alan-bov/frisbee_tracker/reference material/IO Chart for Programming Reference.pptx

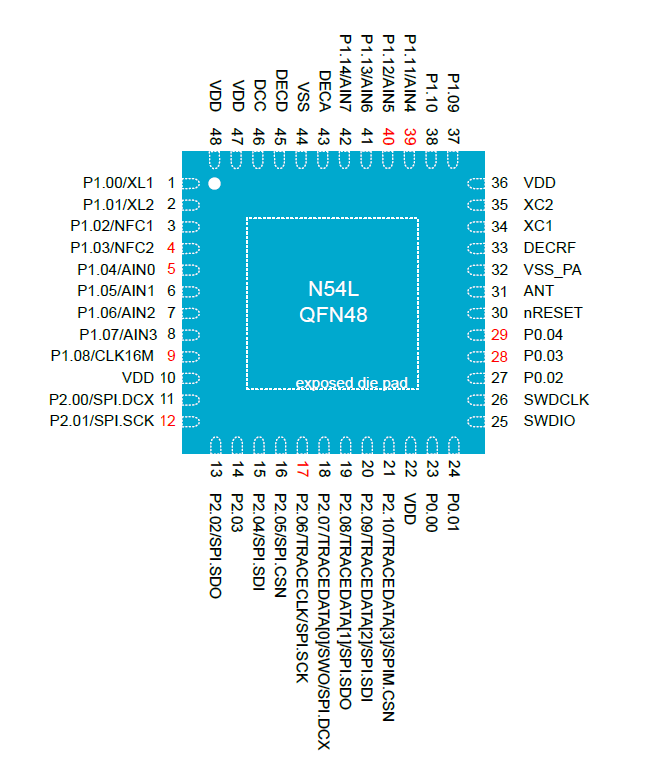
[picture p1: figure]

Analog reading of
voltage across battery

From BMI323
I2C communication lines

V_bat Input

SDA Line

SCL Line

INT2

From BMI323
INT1 and INT2 configurable

INT1

Charging LED indicators
D1 on top, D4 on bottom

D1 Toggle

D2 Toggle

D3 Toggle

D4 Toggle

Note: Default I2C address of BMI 323 is 0x68

PGOOD

CHG

From BQ24072RGTT
PGOOD on when charging complete
CHG on during charging
