alan-bov/frisbee_tracker/reference material/board outline dxf.DXF

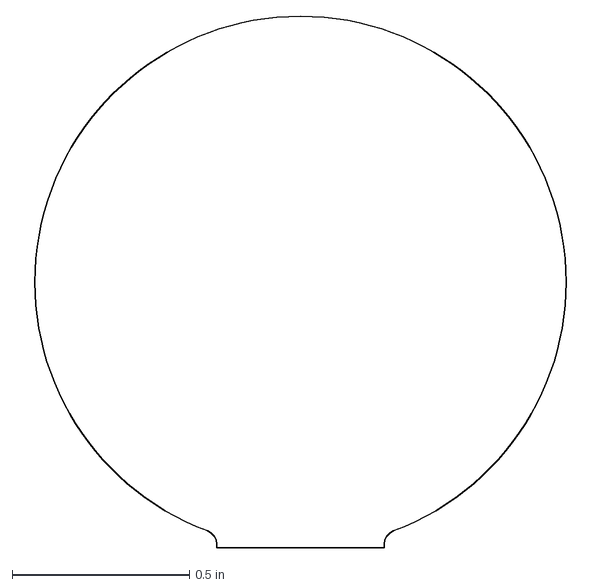
[picture p2: CAD file, 2025-10-27]
reference material/board outline dxf.DXF
1.60 x 1.50 in
