alan-bov/frisbee_tracker/step/SS14.STEP

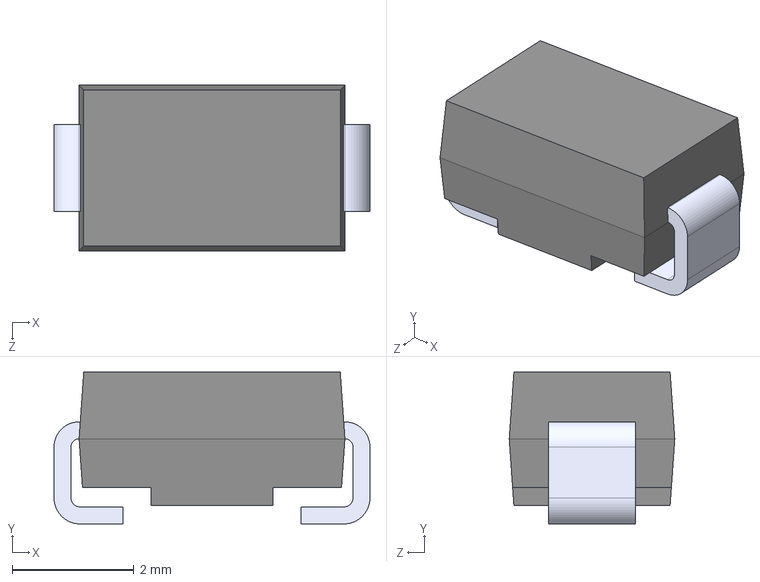
[picture p3: CAD file, 2025-11-05]
step/SS14.STEP
5.20 x 2.50 x 2.72 mm
