alan-bov/frisbee_tracker/step/SMD26PL-TP.stp

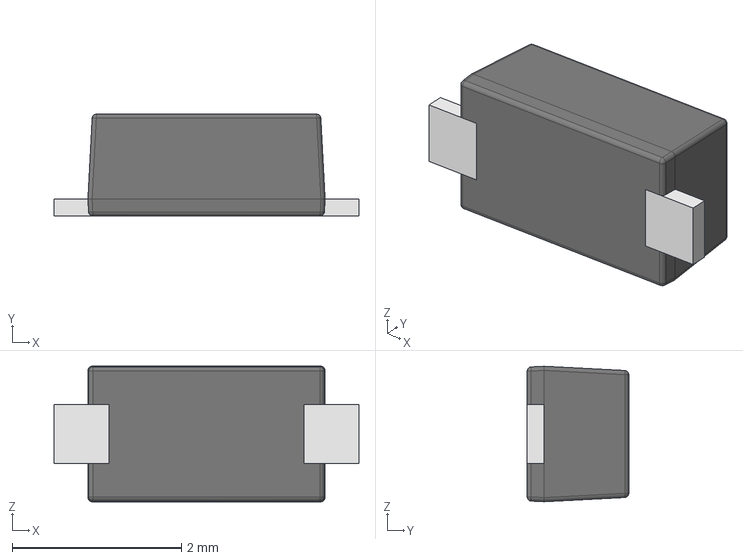
[picture p4: CAD file, 2025-11-05]
step/SMD26PL-TP.stp
3.60 x 1.20 x 1.60 mm
��2
��1
