alan-bov/frisbee_tracker/step/FTSH-103-01-L-D.step

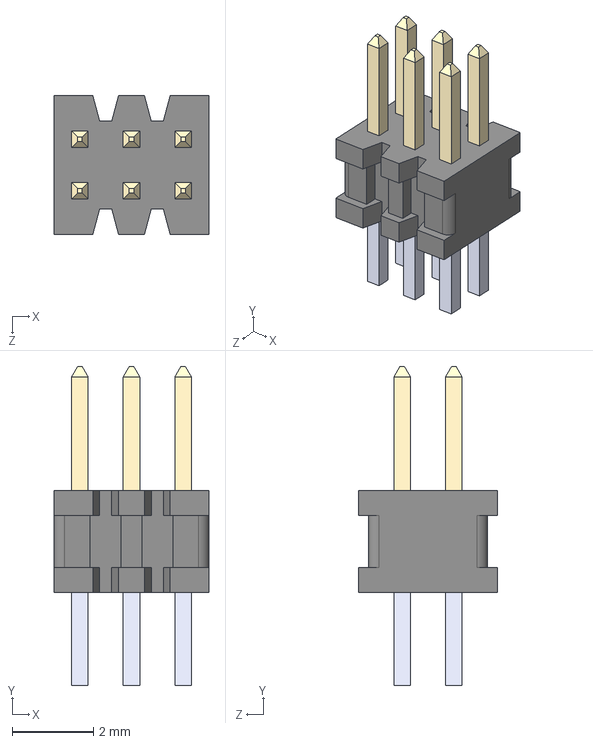
[picture p5: CAD file, 2025-10-31]
step/FTSH-103-01-L-D.step
3.81 x 7.85 x 3.43 mm
