alan-bov/frisbee_tracker/step/BLM18KG121TN1D.step

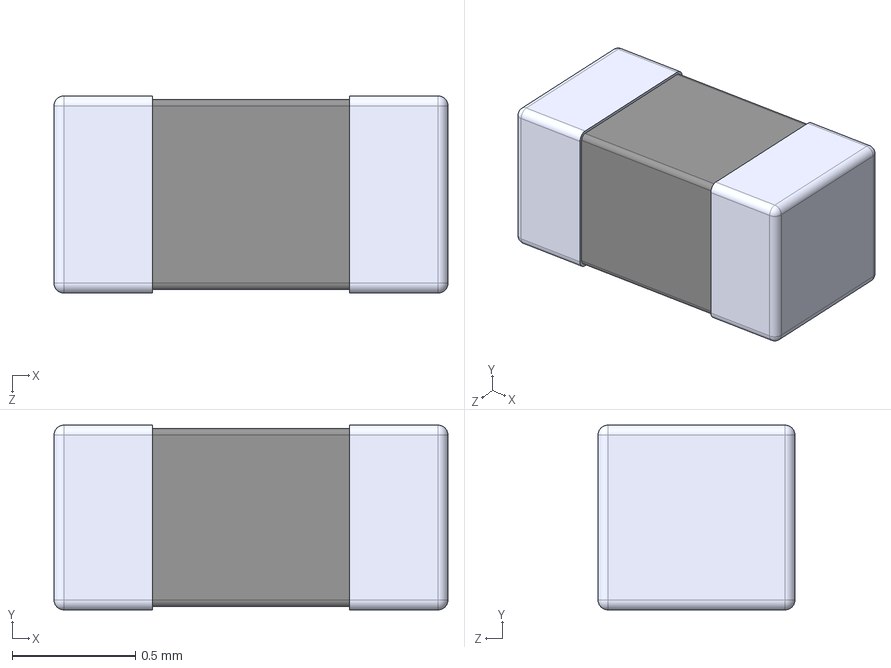
[picture p6: CAD file, 2025-10-27]
step/BLM18KG121TN1D.step
1.60 x 0.75 x 0.8 mm
