alan-bov/frisbee_tracker/step/LQP03HQ3N5B02D.step

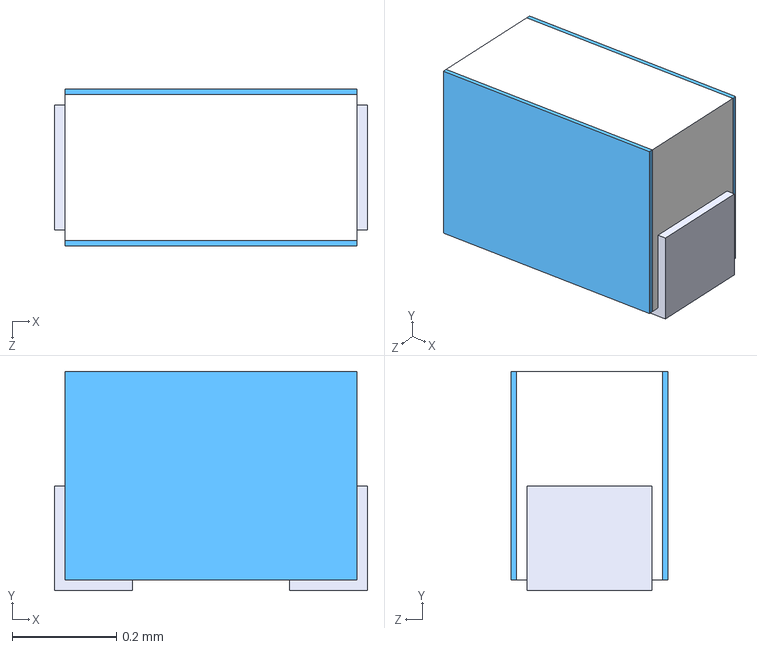
[picture p7: CAD file, 2025-10-27]
step/LQP03HQ3N5B02D.step
0.6 x 0.42 x 0.3 mm
