alan-bov/frisbee_tracker/step/ECS-320-8-37B2-JTY-TR.stp

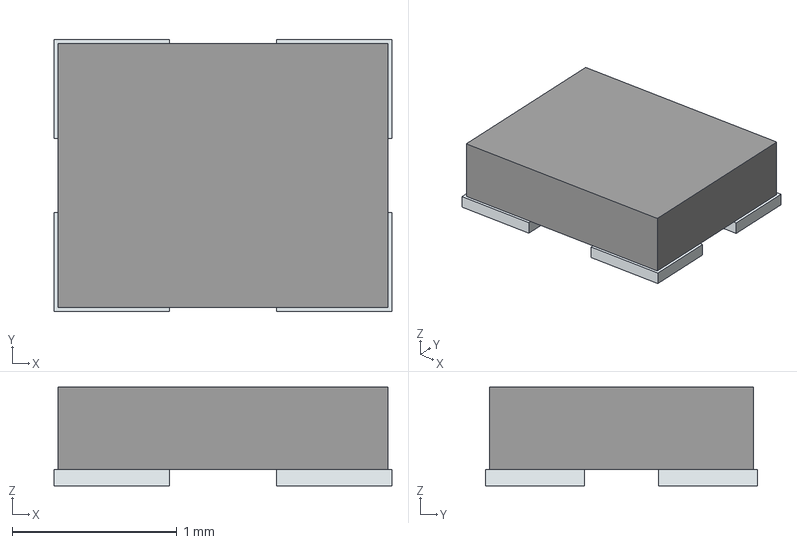
[picture p8: CAD file, 2025-10-27]
step/ECS-320-8-37B2-JTY-TR.stp
2.05 x 1.65 x 0.6 mm
Pins
