alan-bov/frisbee_tracker/step/RFANT3216120A5T.step

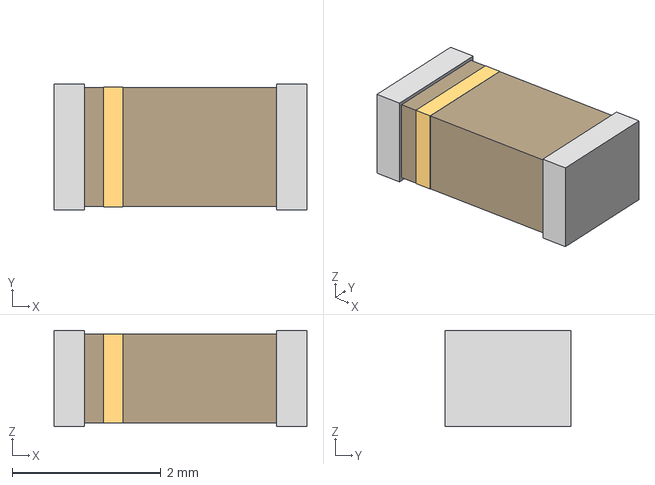
[picture p9: CAD file, 2025-10-24]
step/RFANT3216120A5T.step
3.40 x 1.70 x 1.29 mm
