alan-bov/frisbee_tracker/step/FTSH-105-01-L-DV-K.stp

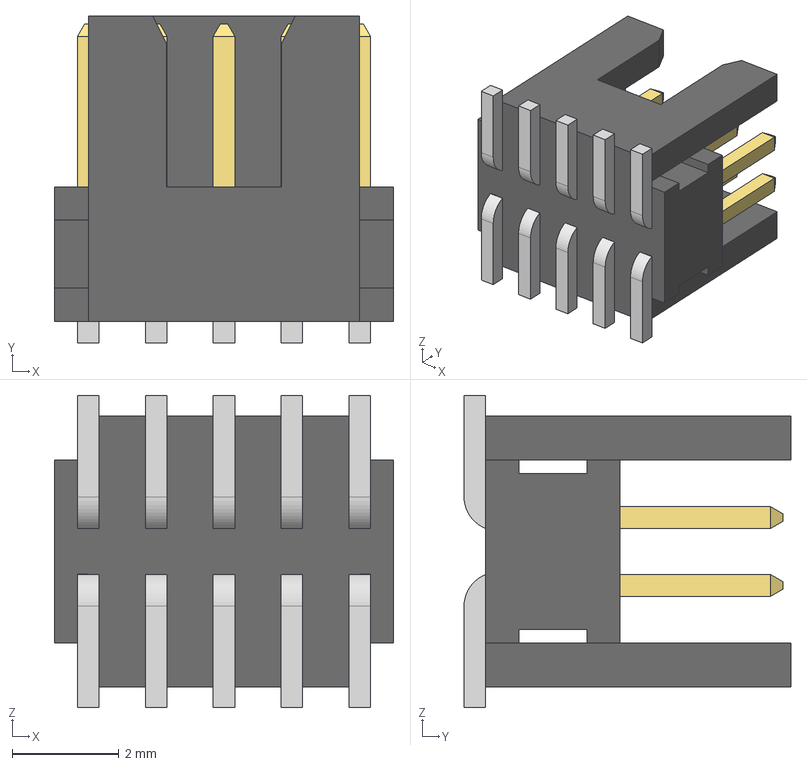
[picture p10: CAD file, 2025-10-24]
step/FTSH-105-01-L-DV-K.stp
6.35 x 6.12 x 5.84 mm
FTSH-105-01-L-DV-K_body
FTSH-105-01-L-DV-K_pins1
FTSH-105-01-L-DV-K_pins2
