alan-bov/frisbee_tracker/step/BSS138.step

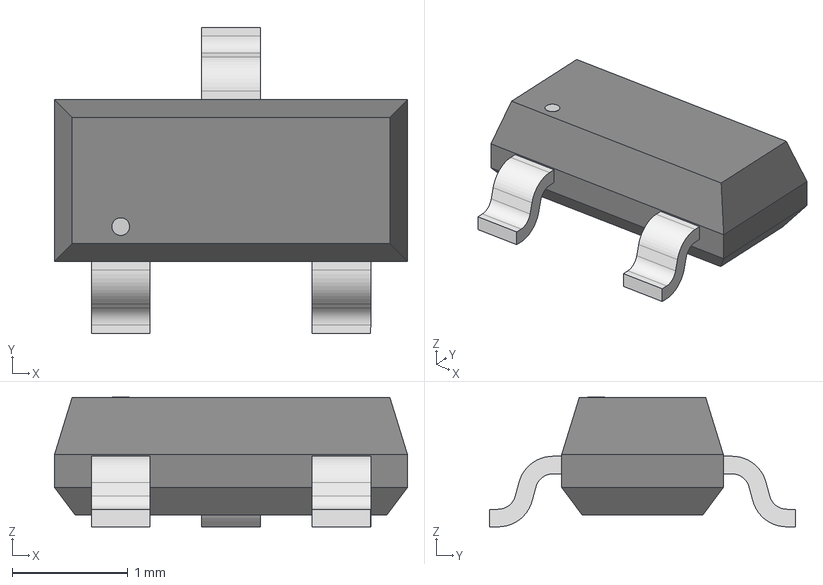
[picture p11: CAD file, 2025-10-24]
step/BSS138.step
3.05 x 2.64 x 1.12 mm
