alan-bov/frisbee_tracker/step/AP2210N-3.3TRG1.step

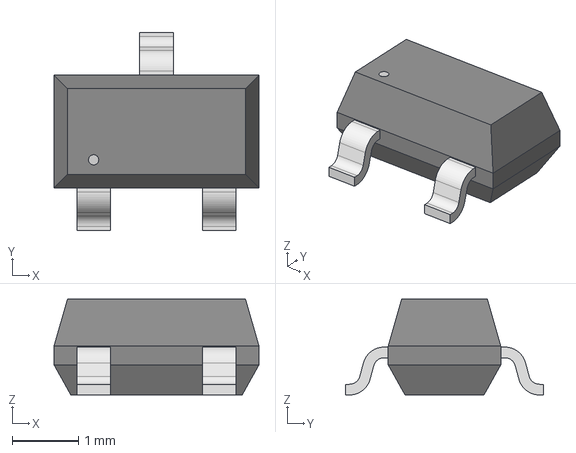
[picture p12: CAD file, 2025-10-23]
step/AP2210N-3.3TRG1.step
3.10 x 3.00 x 1.45 mm
