alan-bov/frisbee_tracker/step/NRF54L05-QFAA-R7.stp

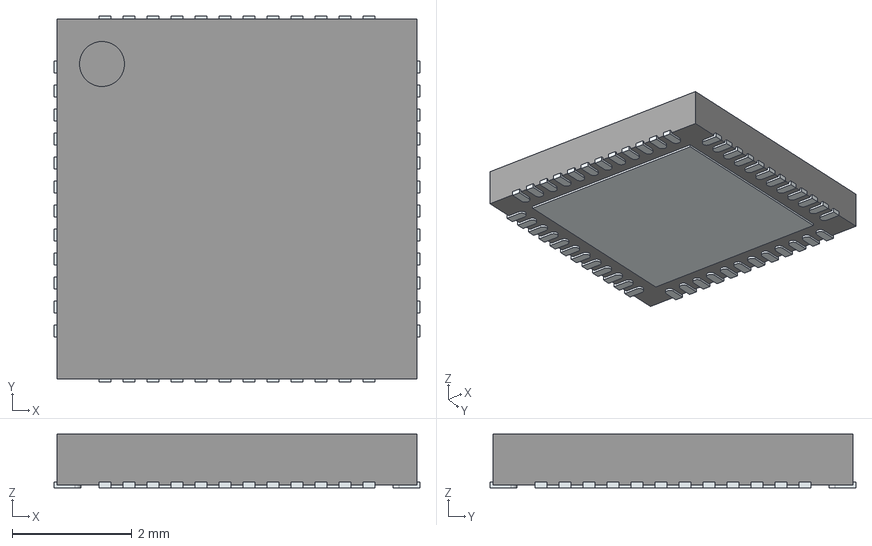
[picture p13: CAD file, 2025-10-23]
step/NRF54L05-QFAA-R7.stp
6.10 x 6.10 x 0.9 mm
ThermalPin
PinsArrayLR
PinsArrayTB
