alan-bov/frisbee_tracker/step/BMI323.step

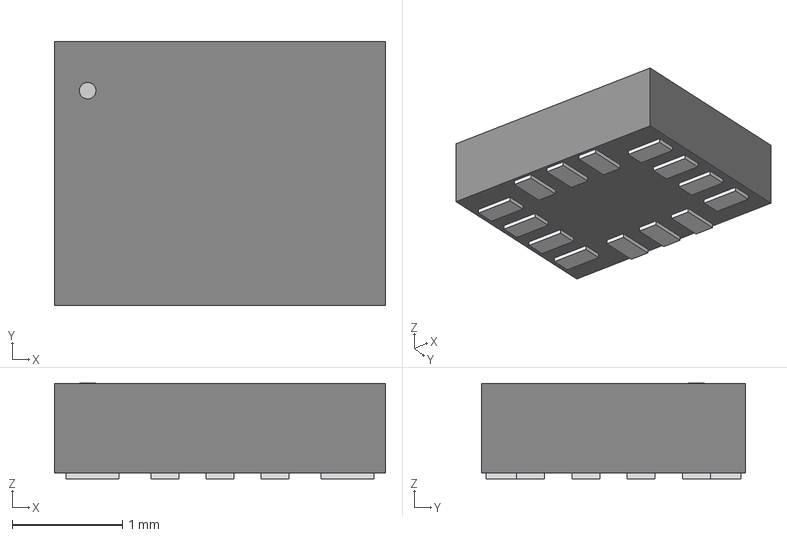
[picture p14: CAD file, 2025-10-23]
step/BMI323.step
3.00 x 2.39 x 0.866 mm
