alan-bov/frisbee_tracker/step/UJC-H-G-SMT-2-P6-TR.step

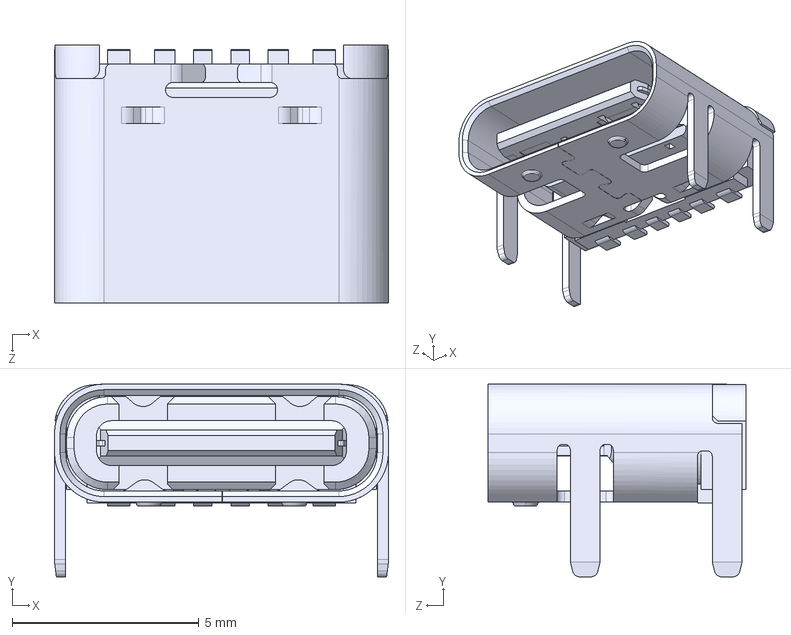
[picture p15: CAD file, 2025-10-23]
step/UJC-H-G-SMT-2-P6-TR.step
8.94 x 5.16 x 6.90 mm
