alan-bov/frisbee_tracker/step/BQ24072RGTT.step

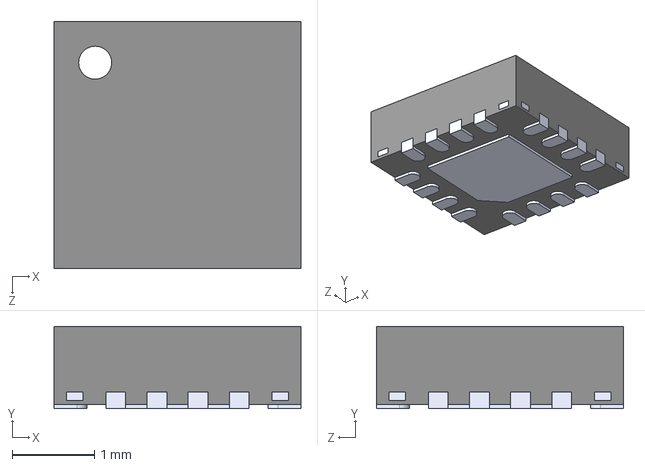
[picture p16: CAD file, 2025-10-23]
step/BQ24072RGTT.step
3.00 x 1.00 x 3.00 mm
