alan-bov/frisbee_tracker/(list of files, drawings)

Other design files:
reference material/nRF54L15-QFAA Reference Layout 0_8/Altium Designer files/nRF54L15_qfaa_4L_config1.PcbDoc
reference material/nRF54L15-QFAA Reference Layout 0_8/Altium Designer files/nRF54L15_qfaa_4L_config1.PrjPCB
reference material/nRF54L15-QFAA Reference Layout 0_8/Altium Designer files/nRF54L15_qfaa_4L_config1.SchDoc
