alan-bov/frisbee_tracker/frisbee_tracker/frisbee_tracker.kicad_pcb

## KiCad design frisbee_tracker/frisbee_tracker.kicad_pcb (2025-11-05)

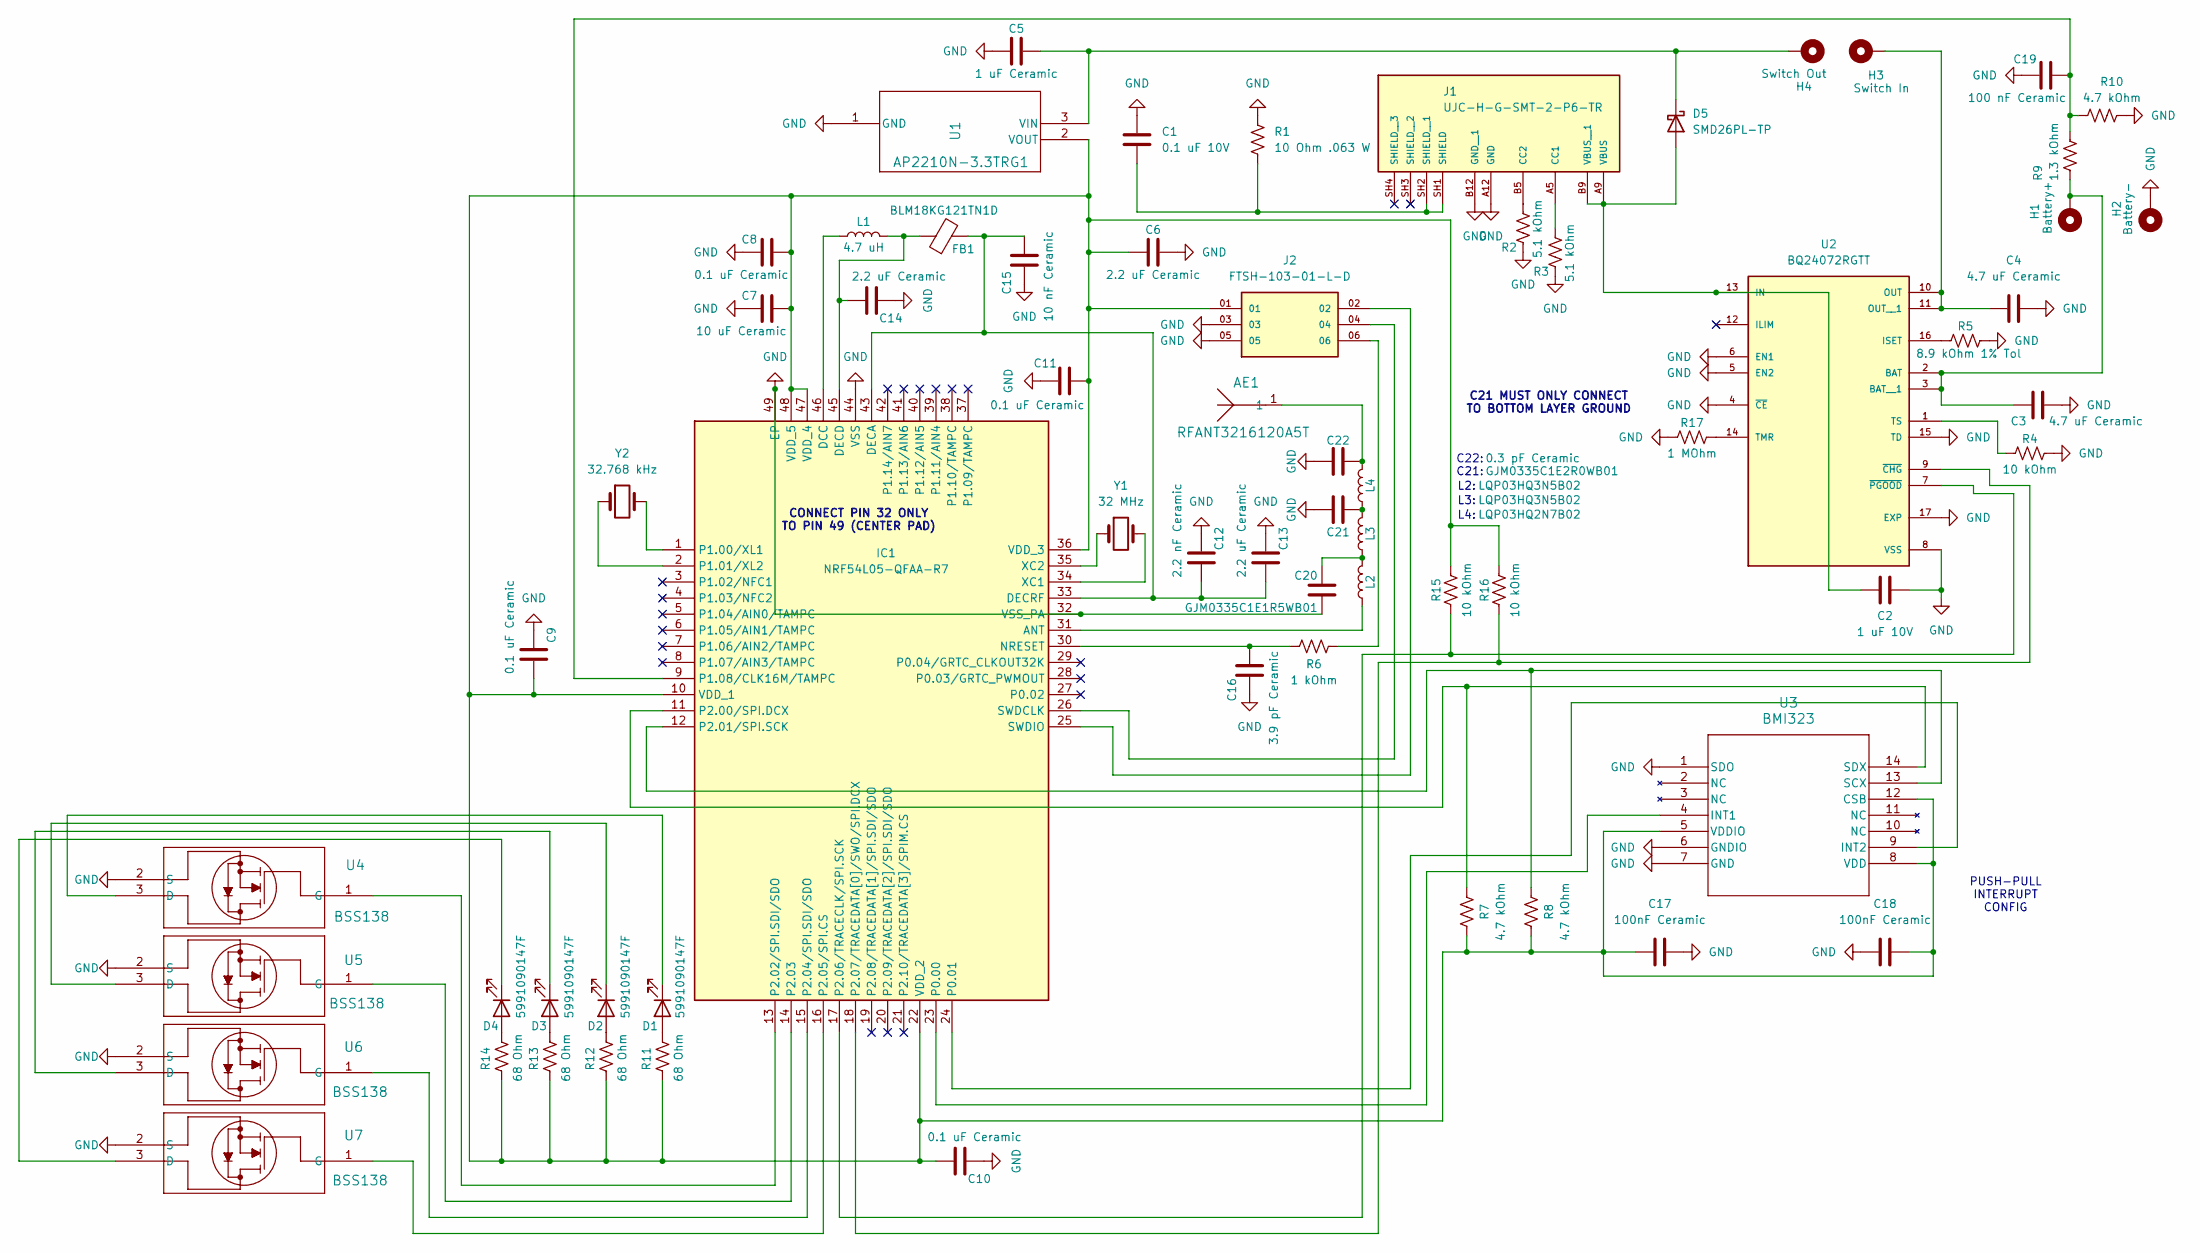
[picture p17: schematic frisbee_tracker.kicad_sch]

Parts:
AE1: RFANT3216120A5T
C1: 0.1 uF 10V; C_0603_1608Metric
C2: 1 uF 10V; C_0603_1608Metric
C3, C4: 4.7 uF Ceramic; C_0603_1608Metric
C5: 1 uF Ceramic; C_0603_1608Metric
C6, C13, C14: 2.2 uF Ceramic; C_0603_1608Metric
C7: 10 uF Ceramic; C_0603_1608Metric
C8, C9, C10, C11: 0.1 uF Ceramic; C_0603_1608Metric
C12: 2.2 nF Ceramic; C_0603_1608Metric
C15: 10 nF Ceramic; C_0603_1608Metric
C16: 3.9 pF Ceramic; C_0603_1608Metric
C17, C18: 100nF Ceramic; C_0603_1608Metric
C19: 100 nF Ceramic; C_0603_1608Metric
C20: GJM0335C1E1R5WB01; C_0201_0603Metric
C21: GJM0335C1E2R0WB01; C_0201_0603Metric
C22: 0.3 pF Ceramic; C_0603_1608Metric
D1, D2, D3, D4: 5991090147F; LED_0603_1608Metric
D5: SMD26PL-TP
FB1: BLM18KG121TN1D
H1: Battery+; PinHeader_1x01_P1.27mm_Vertical
H2: Battery-; PinHeader_1x01_P1.27mm_Vertical
H3: Switch In; PinHeader_1x01_P1.27mm_Vertical
H4: Switch Out; PinHeader_1x01_P1.27mm_Vertical
IC1: NRF54L05-QFAA-R7; Mouser Part Number 949-NRF54L05-QFAA-R7
J1: UJC-H-G-SMT-2-P6-TR; PARTREV 1.0
J2: FTSH-103-01-L-D; PARTREV B
L1: 4.7 uH; L_0603_1608Metric
L2: LQP03HQ2N7B02; LQP03HQ2N7B02D
L3, L4: LQP03HQ3N5B02; LQP03HQ3N5B02D
R1: 10 Ohm .063 W; R_0603_1608Metric
R2, R3: 5.1 kOhm; R_0603_1608Metric
R4, R15, R16: 10 kOhm; R_0603_1608Metric
R5: 8.9 kOhm 1% Tol; R_0603_1608Metric
R6: 1 kOhm; R_0603_1608Metric
R7, R8, R10: 4.7 kOhm; R_0603_1608Metric
R9: 1.3 kOhm; R_0603_1608Metric
R11, R12, R13, R14: 68 Ohm; R_0603_1608Metric
R17: 1 MOhm; R_0603_1608Metric
U1: AP2210N-3.3TRG1
U2: BQ24072RGTT; PARTREV N
U3: BMI323
U4, U5, U6, U7: BSS138
Y1: 32 MHz; ECS-320-8-37B2-JTY-TR
Y2: 32.768 kHz; Q 0,032768-JTX210-7-20-T1-HMR-70K-LF

Connections:
unnamed: AE1.1, C22.2, L4.2
unnamed: C20.2, L2.2, L3.1
unnamed: C21.1, L3.2, L4.1
unnamed: D1.2 (A), R11.1
unnamed: D1.1 (K), U4.3 (D)
unnamed: D2.2 (A), R12.1
unnamed: D2.1 (K), U5.3 (D)
unnamed: D3.2 (A), R13.1
unnamed: D3.1 (K), U6.3 (D)
unnamed: D4.2 (A), R14.1
unnamed: D4.1 (K), U7.3 (D)
unnamed: C2.1, D5.2 (A), J1.A9 (VBUS), J1.B9 (VBUS__1), U2.13 (IN)
unnamed 12: C5.2, D5.1 (K), H4.1, U1.3 (VIN); also elsewhere on the board
unnamed: IC1.31 (ANT), L2.1
unnamed: IC1.46 (DCC), L1.1
unnamed: C12.2, C13.2, C15.2, FB1.2, IC1.33 (DECRF), IC1.43 (DECA)
unnamed: C14.2, FB1.1, IC1.45 (DECD), L1.2
unnamed: C16.2, IC1.30 (NRESET), R6.1
unnamed: IC1.23 (P0.00), U3.4 (INT1)
unnamed: IC1.24 (P0.01), U3.9 (INT2)
unnamed: IC1.1 (P1.00/XL1), Y2.2
unnamed: IC1.2 (P1.01/XL2), Y2.1
unnamed: C19.2, IC1.9 (P1.08/CLK16M/TAMPC), R9.1, R10.1
unnamed: IC1.11 (P2.00/SPI.DCX), R7.2, U3.14 (SDX)
unnamed: IC1.12 (P2.01/SPI.SCK), R8.2, U3.13 (SCX)
unnamed: IC1.13 (P2.02/SPI.SDI/SDO), U4.1 (G)
unnamed: IC1.14 (P2.03), U5.1 (G)
unnamed: IC1.15 (P2.04/SPI.SDI/SDO), U6.1 (G)
unnamed: IC1.16 (P2.05/SPI.CS), U7.1 (G)
unnamed: IC1.17 (P2.06/TRACECLK/SPI.SCK), R15.1, U2.7 (~PGOOD)
unnamed: IC1.18 (P2.07/TRACEDATA[0]/SWO/SPI.DCX), R16.1, U2.9 (~CHG)
unnamed: IC1.26 (SWDCLK), J2.04
unnamed: IC1.25 (SWDIO), J2.02
unnamed: C6.1, C7.2, C8.2, C9.2, C10.2, C11.2, C17.1, C18.2, IC1.10 (VDD_1), IC1.22 (VDD_2), IC1.36 (VDD_3), IC1.47 (VDD_4), IC1.48 (VDD_5), J2.01, R7.1, R8.1, R11.2, R12.2, R13.2, R14.2, R15.2, R16.2, U1.2 (VOUT), U3.5 (VDDIO), U3.8 (VDD), U3.12 (CSB)
unnamed: IC1.35 (XC2), Y1.1
unnamed: J1.A5 (CC1), R3.1
unnamed: J1.B5 (CC2), R2.1
unnamed: C1.2, J1.SH1 (SHIELD), J1.SH2 (SHIELD__1), R1.2
unnamed: J2.06, R6.2
unnamed 39: C3.1, H1.1, R9.2, U2.2 (BAT), U2.3 (BAT__1); also elsewhere on the board
unnamed: R5.1, U2.16 (ISET)
unnamed 41: C4.1, H3.1, U2.10 (OUT), U2.11 (OUT__1); also elsewhere on the board
unnamed: R17.2, U2.14 (TMR)
unnamed: R4.1, U2.1 (TS)

Notes on the sheet:
C21:
CONNECT PIN 32 ONLY TO PIN 49 (CENTER PAD)
L3:
C21 MUST ONLY CONNECT TO BOTTOM LAYER GROUND
L4:
C22:
L2:
PUSH-PULL INTERRUPT CONFIG

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
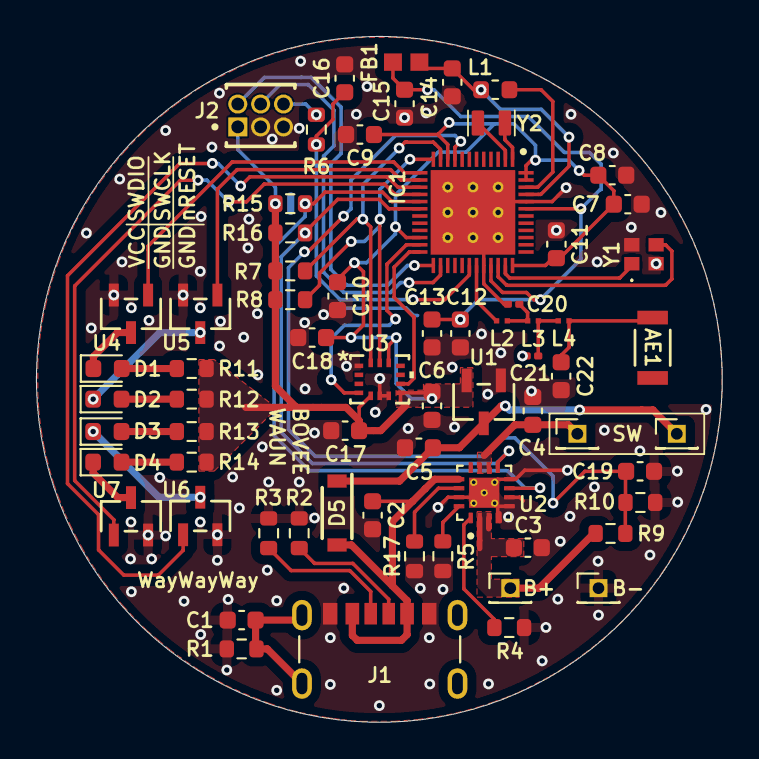
[picture p18: board frisbee_tracker.kicad_pcb from above]

Board: 2 copper layers, 38.1 x 38.1 mm, 66 parts (0 on the bottom side), 46 nets.

Other parts of the board:
B+: Battery+; PinHeader_1x01_P1.27mm_Vertical
B-: Battery-; PinHeader_1x01_P1.27mm_Vertical
SW: Switch Out; PinHeader_1x01_P1.27mm_Vertical
SW#2: Switch In; PinHeader_1x01_P1.27mm_Vertical

Their connections:
unnamed 12: SW.1; also elsewhere on the board
unnamed 39: B+.1; also elsewhere on the board
unnamed 41: SW#2.1; also elsewhere on the board
