alan-bov/frisbee_tracker/(commit log)

2025-10-23 started schematic design
    [frisbee_tracker.kicad_pcb, frisbee_tracker.kicad_sch]
2025-10-24 Rough draft of schematic complete
    [BSS138.step, FTSH-105-01-L-DV-K.stp, RFANT3216120A5T.step, frisbee_tracker.kicad_sch]
2025-10-27 start of PCB design
    [BLM18KG121TN1D.step, ECS-320-8-37B2-JTY-TR.stp, LQP03HQ2N7B02D.step, LQP03HQ3N5B02D.step, board outline dxf.DXF, frisbee_tracker.kicad_pcb, frisbee_tracker.kicad_sch]
2025-10-28 PCB design 75 percent complete
    [frisbee_tracker.kicad_pcb]
2025-10-29 rework on controller PCB wiring started
    [frisbee_tracker.kicad_pcb]
2025-10-30 PCB rework of MCU
    [frisbee_tracker.kicad_pcb]
2025-10-31 PCB design 90% complete
    [FTSH-103-01-L-D.step, frisbee_tracker.kicad_pcb, frisbee_tracker.kicad_sch]
2025-11-03 Rough draft of PCB completed
    [frisbee_tracker.kicad_pcb, frisbee_tracker.kicad_sch]
2025-11-05 Added switch and Shottky diode to schematic
    [SMD26PL-TP.stp, SS14.STEP, frisbee_tracker.kicad_pcb, frisbee_tracker.kicad_sch]
2025-11-05 PCB design complete and Gerbers generated
    [frisbee_tracker-B_Cu.gbl, frisbee_tracker-B_Mask.gbs, frisbee_tracker-B_Silkscreen.gbo, frisbee_tracker-Edge_Cuts.gm1, frisbee_tracker-F_Cu.gtl, frisbee_tracker-F_Mask.gts, frisbee_tracker-F_Silkscreen.gto, frisbee_tracker-NPTH.drl]
