alan-bov/frisbee_tracker/(notices)

Notices in the files:
step/FTSH-105-01-L-DV-K.stp:
author */ ('License CC BY-ND 4.0'),
